chirpy8/canbus_x100/AxleRatioChange/Images/IMG_0645.JPG

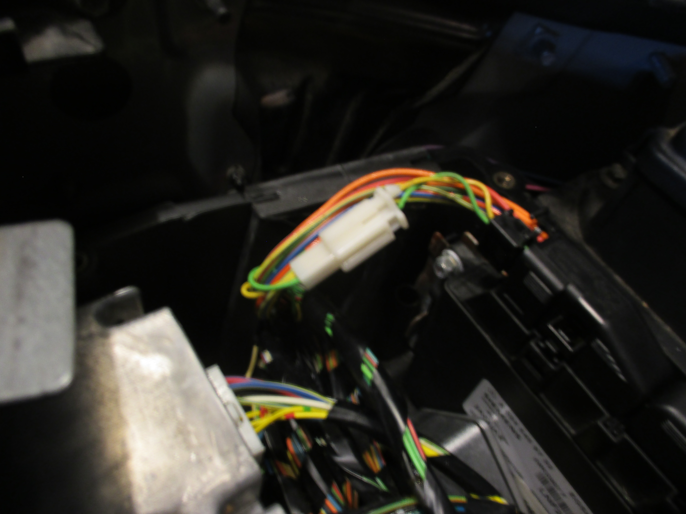
AxleRatioChange/Images/IMG_0645.JPG
