chirpy8/canbus_x100/AxleRatioChange/Kicad/Axle Ratio Change.kicad_pcb

## KiCad design AxleRatioChange/Kicad/Axle Ratio Change.kicad_pcb (2021-07-27)

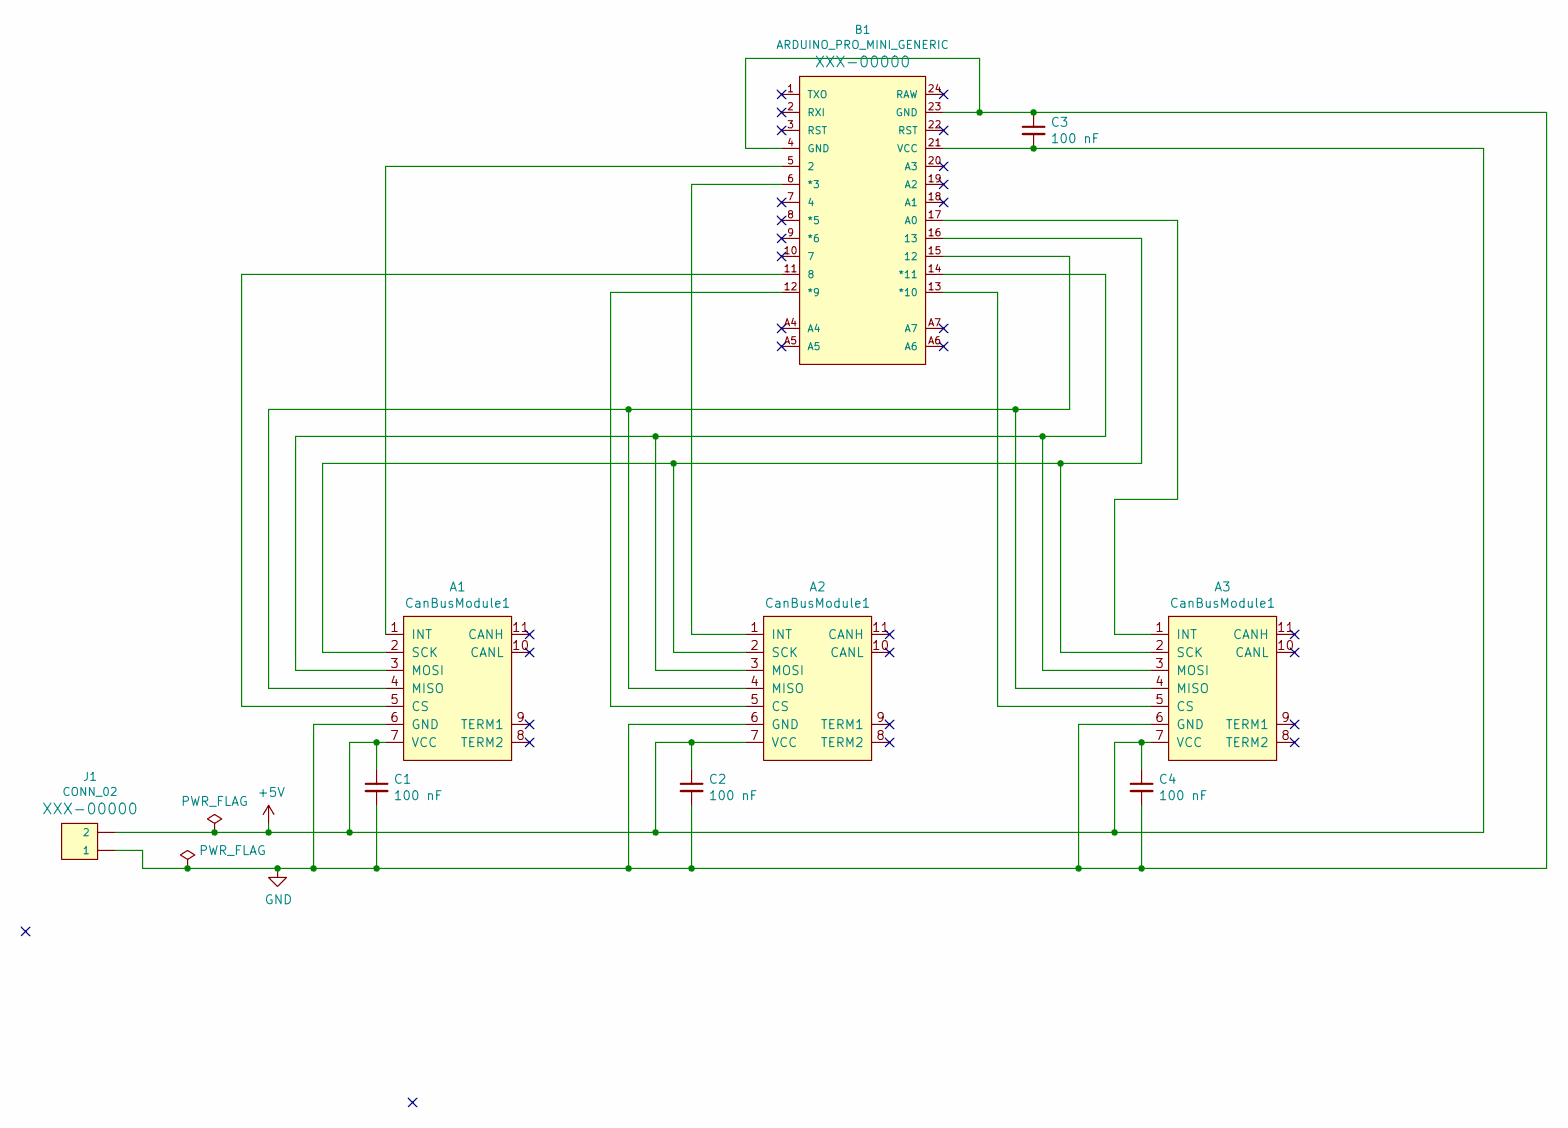
[picture p4: schematic Axle Ratio Change.sch, Can Bus repeater and monitor]

Parts:
A1, A2, A3: CanBusModule1
B1: ARDUINO_PRO_MINI_GENERIC; Arduino_Pro_Mini_Generic
C1, C2, C3, C4: 100 nF; C_Disc_D3.0mm_W2.0mm_P2.50mm
J1: CONN_02; 1X02

Connections:
+5V: A1.7 (VCC), A2.7 (VCC), A3.7 (VCC), B1.21 (VCC), C1.1, C2.1, C3.2, C4.1, J1.2
GND: A1.6 (GND), A2.6 (GND), A3.6 (GND), B1.4 (GND), B1.23 (GND), C1.2, C2.2, C3.1, C4.2, J1.1
unnamed: A1.1 (INT), B1.5 (2)
unnamed: A1.2 (SCK), A2.2 (SCK), A3.2 (SCK), B1.16 (13)
unnamed: A1.3 (MOSI), A2.3 (MOSI), A3.3 (MOSI), B1.14 (*11)
unnamed: A1.4 (MISO), A2.4 (MISO), A3.4 (MISO), B1.15 (12)
unnamed: A1.5 (CS), B1.11 (8)
unnamed: A2.1 (INT), B1.6 (*3)
unnamed: A2.5 (CS), B1.12 (*9)
unnamed: A3.1 (INT), B1.17 (A0)
unnamed: A3.5 (CS), B1.13 (*10)

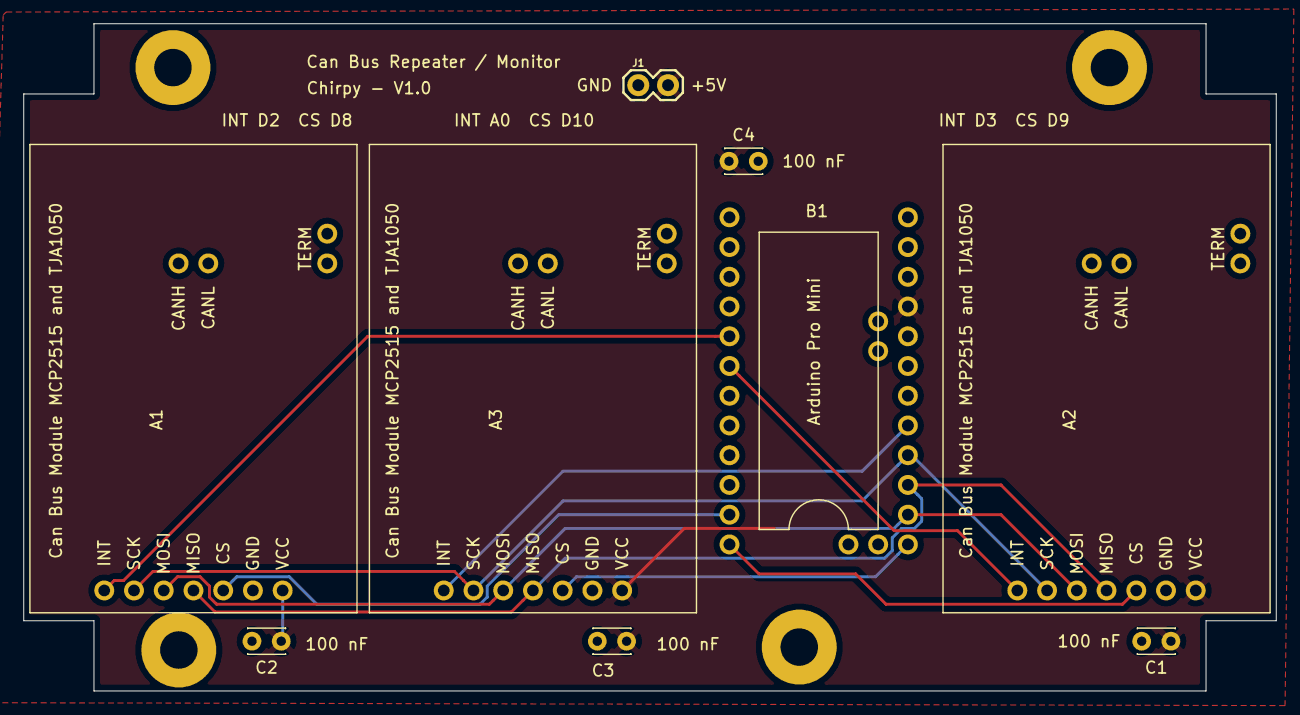
[picture p5: board Axle Ratio Change.kicad_pcb from above]

Board: 2 copper layers, 107.0 x 57.0 mm, 9 parts (0 on the bottom side), 11 nets.
