chirpy8/canbus_x100/(commit log)

2021-07-27 initial project version
    [Axle Ratio Change-B_Cu.gbr, Axle Ratio Change-B_Mask.gbr, Axle Ratio Change-B_SilkS.gbr, Axle Ratio Change-Edge_Cuts.gbr, Axle Ratio Change-F_Cu.gbr, Axle Ratio Change-F_Mask.gbr, Axle Ratio Change-F_SilkS.gbr, Axle Ratio Change-NPTH.drl]
2025-05-20 Update canbusRatioModifier.ino to address issues with chip reset time variability
    Added significant delay (3.125 us) after each MCP2515 reset command as some board samples seem to require this to function correctly
    [canbusRatioModifier.ino]
